RashenPerera/STM32-Spectrum-Analyzer/Core/Src/main.c

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
/* Includes ------------------------------------------------------------------*/
#include "main.h"

/* USER CODE BEGIN Includes */
#include "ili9341.h"
#define ARM_MATH_CM3
#include "arm_math.h"
#include "arm_const_structs.h"
#include <math.h>
#include "fonts.h"
/* USER CODE END Includes */

ADC_HandleTypeDef hadc1;
DMA_HandleTypeDef hdma_adc1;

TIM_HandleTypeDef htim3;

/* USER CODE BEGIN PV */
#define FFT_SAMPLES 512

q15_t hann_window[FFT_SAMPLES];
uint16_t adc_buffer[FFT_SAMPLES];
q15_t fft_input[FFT_SAMPLES * 2];
q15_t fft_magnitudes[FFT_SAMPLES];

// Display variables upgraded to 64 bars!
uint8_t display_bars[64] = {0};
uint8_t previous_bars[64] = {0};

volatile uint8_t fft_ready = 0;
uint8_t first_frame = 1;
/* USER CODE END PV */

void SystemClock_Config(void);
static void MX_GPIO_Init(void);
static void MX_DMA_Init(void);
static void MX_ADC1_Init(void);
static void MX_TIM3_Init(void);
/**
  * @brief  The application entry point.
  * @retval int
  */
int main(void)
{

  /* MCU Configuration--------------------------------------------------------*/

  /* Reset of all peripherals, Initializes the Flash interface and the Systick. */
  HAL_Init();

  /* Configure the system clock */
  SystemClock_Config();

  /* USER CODE BEGIN SysInit */
  // 1. FORCIBLY UNLOCK JTAG PINS BEFORE GPIO INIT
  __HAL_RCC_AFIO_CLK_ENABLE();
  __HAL_AFIO_REMAP_SWJ_NOJTAG();
  /* USER CODE END SysInit */

  /* Initialize all configured peripherals */
  MX_GPIO_Init();
  MX_DMA_Init();
  MX_ADC1_Init();
  MX_TIM3_Init();
  /* USER CODE BEGIN 2 */
  ILI9341_Init();
  ILI9341_FillScreen(ILI9341_BLACK);

    // Pre-calculate the Hann Window
  for (int i = 0; i < FFT_SAMPLES; i++) {
      float multiplier = 0.5f * (1.0f - cos(2.0f * 3.14159265f * i / (FFT_SAMPLES - 1)));
      hann_window[i] = (q15_t)(multiplier * 32767.0f);
  }

  HAL_ADCEx_Calibration_Start(&hadc1);
  HAL_TIM_Base_Start(&htim3);
  HAL_ADC_Start_DMA(&hadc1, (uint32_t*)adc_buffer, FFT_SAMPLES);
  /* USER CODE END 2 */

  /* Infinite loop */
  /* USER CODE BEGIN WHILE */
  while (1)
  {
    /* USER CODE END WHILE */

    /* USER CODE BEGIN 3 */
	  if (fft_ready == 1)
	      {
	          if (first_frame == 1)
	          {
	              ILI9341_FillScreen(ILI9341_BLACK);
	              ILI9341_FillRectangle(0, 230, 320, 1, ILI9341_WHITE);
	              ILI9341_WriteString(2,   232, "0",     Font_7x10, ILI9341_WHITE, ILI9341_BLACK);
	              ILI9341_WriteString(70,  232, "2.5k",  Font_7x10, ILI9341_WHITE, ILI9341_BLACK);
	              ILI9341_WriteString(150, 232, "5k",    Font_7x10, ILI9341_WHITE, ILI9341_BLACK);
	              ILI9341_WriteString(220, 232, "7.5k",  Font_7x10, ILI9341_WHITE, ILI9341_BLACK);
				  ILI9341_WriteString(290, 232, "10k",   Font_7x10, ILI9341_WHITE, ILI9341_BLACK);
	              first_frame = 0;
	          }
	          uint32_t dc_sum = 0;
	          for (int i = 0; i < FFT_SAMPLES; i++) dc_sum += adc_buffer[i];
	          int16_t dc_bias = dc_sum / FFT_SAMPLES;

	          for (int i = 0; i < FFT_SAMPLES; i++)
	          {
	              int16_t centered_adc = adc_buffer[i] - dc_bias;
	              q15_t gained_adc = (q15_t)(centered_adc * 8);
	              fft_input[i * 2] = (q15_t)(((int32_t)gained_adc * hann_window[i]) >> 15);
	              fft_input[(i * 2) + 1] = 0;
	          }
	          arm_cfft_q15(&arm_cfft_sR_q15_len512, fft_input, 0, 1);
	          arm_cmplx_mag_q15(fft_input, fft_magnitudes, FFT_SAMPLES);

	          int bin_index = 2; // Skip DC noise bins
	          for (int i = 0; i < 64; i++)
	          {
	              uint32_t sum = 0;
	              for (int j = 0; j < 4; j++) sum += fft_magnitudes[bin_index++];
	              uint32_t scaled_value = sum / 4;
	              if (scaled_value > 230) scaled_value = 230;
	              if (scaled_value > display_bars[i]) {
	                  display_bars[i] = scaled_value;
	              } else {
	                  if (display_bars[i] > 5) display_bars[i] -= 5; // Fall faster due to taller screen
	                  else display_bars[i] = 0;
	              }
	          }

	          // 5. Draw the 64 bars to the ILI9341
	          for (int i = 0; i < 64; i++)
	          {
	              if (display_bars[i] != previous_bars[i])
	              {
	                  uint16_t x_pos = i * 5; // 5 pixels wide per bar

	                  if (display_bars[i] > previous_bars[i])
	                  {
	                      uint8_t green_h = (display_bars[i] > 120) ? 120 : display_bars[i];
	                      ILI9341_FillRectangle(x_pos, 230 - green_h, 4, green_h, ILI9341_GREEN);

	                      if (display_bars[i] > 120)
	                      {
	                          uint8_t yellow_h = (display_bars[i] > 190) ? 70 : (display_bars[i] - 120);
	                          ILI9341_FillRectangle(x_pos, 230 - 120 - yellow_h, 4, yellow_h, ILI9341_YELLOW);
	                      }

	                      if (display_bars[i] > 190)
	                      {
	                          uint8_t red_h = display_bars[i] - 190;
	                          ILI9341_FillRectangle(x_pos, 230 - 190 - red_h, 4, red_h, ILI9341_RED);
	                      }
	                  }
	                  else
	                  {
	                      ILI9341_FillRectangle(x_pos, 230 - previous_bars[i], 4, previous_bars[i] - display_bars[i], ILI9341_BLACK);
	                  }
	                  previous_bars[i] = display_bars[i];
	              }
	          }
    fft_ready = 0;
	      }
  }
  /* USER CODE END 3 */
}

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
/* USER CODE BEGIN 4 */
// This function is automatically called by the hardware when DMA is done
void HAL_ADC_ConvCpltCallback(ADC_HandleTypeDef* hadc)
{
    if(hadc->Instance == ADC1)
    {
        fft_ready = 1; // Tell the main loop to wake up and do math
    }
}
/* USER CODE END 4 */
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
