RashenPerera/STM32-Spectrum-Analyzer/(commit log)

2026-05-09 Initial commit: STM32 Audio Spectrum Analyzer firmware
    [latest_Analyzer Debug.cfg, newDisplaySpectrumAnalyzer Debug.cfg, newNewAnalyzer Debug.cfg]
2026-05-10 Fix formatting of Anti-Aliasing Filter description
